tgh-apil/cricoid_phantom/trachea_ring.stl

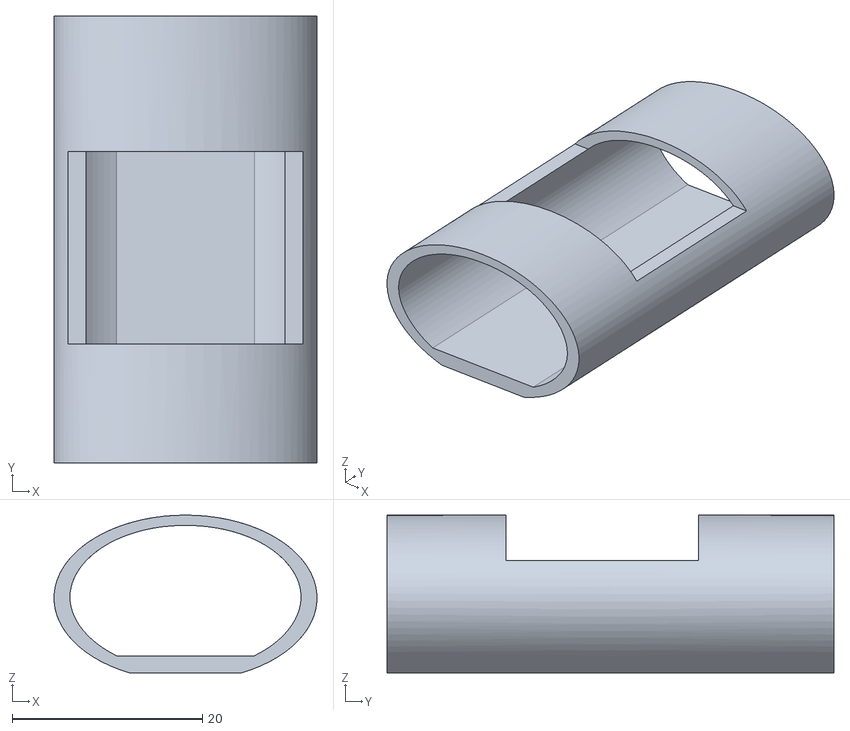
[picture p1: CAD file, 2021-09-13]
trachea_ring.stl
27.6 x 47.0 x 16.6
