tgh-apil/cricoid_phantom/trachea_merged.stl

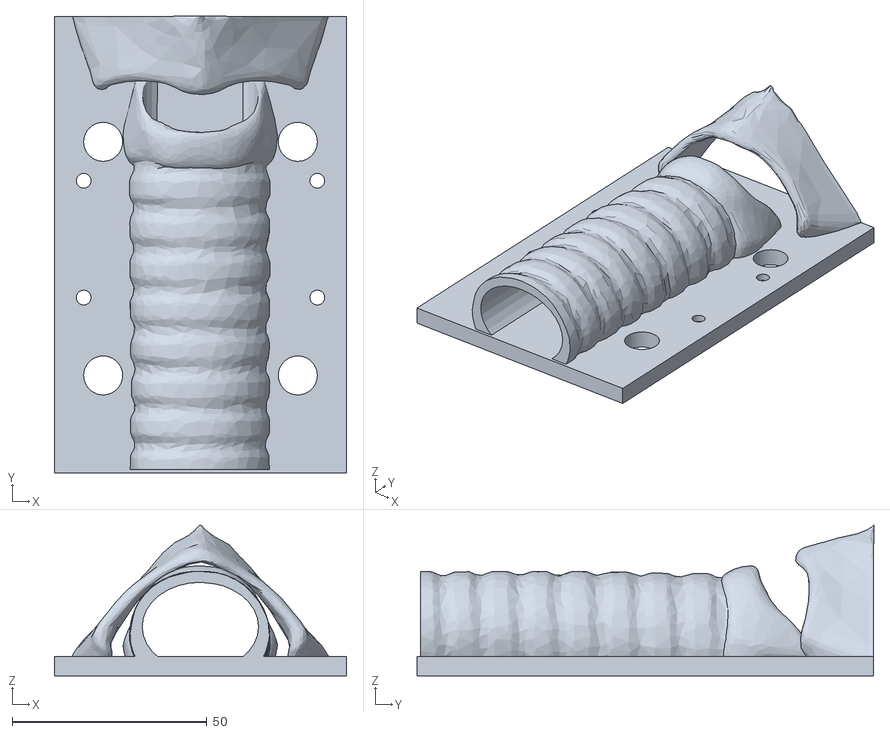
[picture p2: CAD file, 2021-09-10]
trachea_merged.stl
75.0 x 117.3 x 38.8
