tgh-apil/cricoid_phantom/trachea_blocker.stl

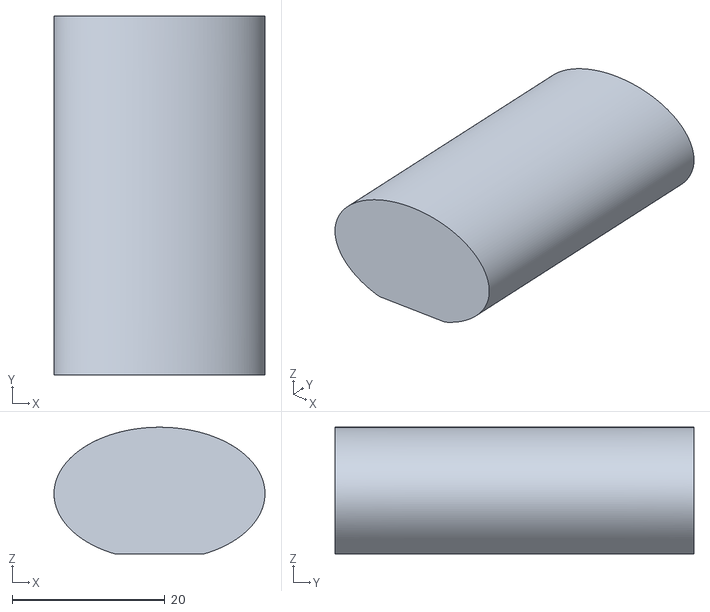
[picture p3: CAD file, 2021-09-10]
trachea_blocker.stl
27.7 x 47.0 x 16.6
