tgh-apil/cricoid_phantom/trachea_silicone_mold_end.stl

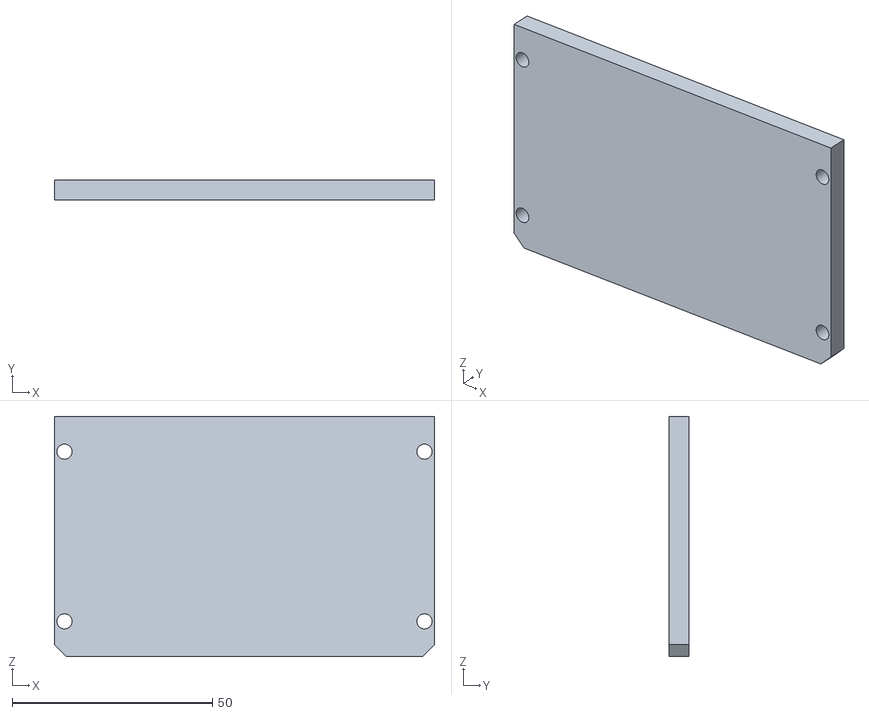
[picture p4: CAD file, 2021-09-10]
trachea_silicone_mold_end.stl
95.0 x 5.00 x 60.0
