tgh-apil/cricoid_phantom/trachea_silicone_mold_body.stl

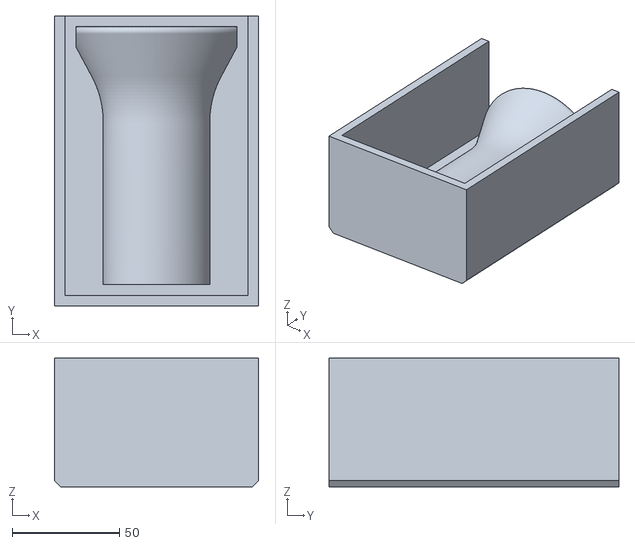
[picture p5: CAD file, 2021-09-10]
trachea_silicone_mold_body.stl
95.0 x 135.0 x 60.0
