tgh-apil/cricoid_phantom/(commit log)

2021-09-10 uploaded stl models and rough instructions
    [trachea_blocker.stl, trachea_merged.stl, trachea_silicone_mold_body.stl, trachea_silicone_mold_end.stl]
2021-09-13 added trachea ring part
    [trachea_ring.stl]
